xing-yuzhiye/-8051-/(list of files, drawings)

Other design files:
ACvolt.pdsprj
STC89C52.PcbLib
STC89C52.SchDoc
STC89C52.SchLib
